CrazyRedMachine/BEMANI_PSX_Adapter/(threads)

Thread 2 (2025-10-01):

Erratic button presses on my BM IIDX arcade style controller's start & select buttons

djash1983, 2025-10-01:
Everything's working great so far on my Beatmania IIDX arcade style controller (JP) with the very same CJMCU Beetle USB that was used on the DIY guide. The difference is that I use a 1.4k resistor (verified it with a digital multimeter), not 1k.

The only issue I have is this:

Whenever I press (or hold) either the start or select button, it does work (showing button 9 on start and 10 on select lit up on window's game controller properties) without problems. But whenever I press either of those buttons repeatedly, it erratically lit another button:

* if I press the start button repeatedly, either button 12 will lit up or both 9 & 12 at the same time
* if I press the select button repeatedly, either button 11 will lit up or both 10 & 11 at the same time

is this normal behavior? or did I mess up with the wiring or the choice of resistor used?

CrazyRedMachine, 2025-10-01:
it's normal behavior so that you can have e3 and e4 button with double or triple click as well as combinations (used in infinitas to exit game iirc)

https://github.com/CrazyRedMachine/BEMANI_PSX_Adapter/blob/2656996185079a7e98e4ff7138340d34041718c0/BEMANI_PSX_Adapter/BEMANI_PSX_Adapter.ino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

you can set this define to 0 to disable this behavior (and read the comment above it for more info)

djash1983, 2025-10-01:
Looks like I haven't paid enough attention to the whole code where there's a defined function explained in full detail thru comment.

I think I'll disable this function since I play the arcade version rips anyway.

Thanks for the assistance.
